2ndStar/denna/denna/CaseDenna/8a386e63-ffc7-4042-83e9-6f8d7a95df95.PNG

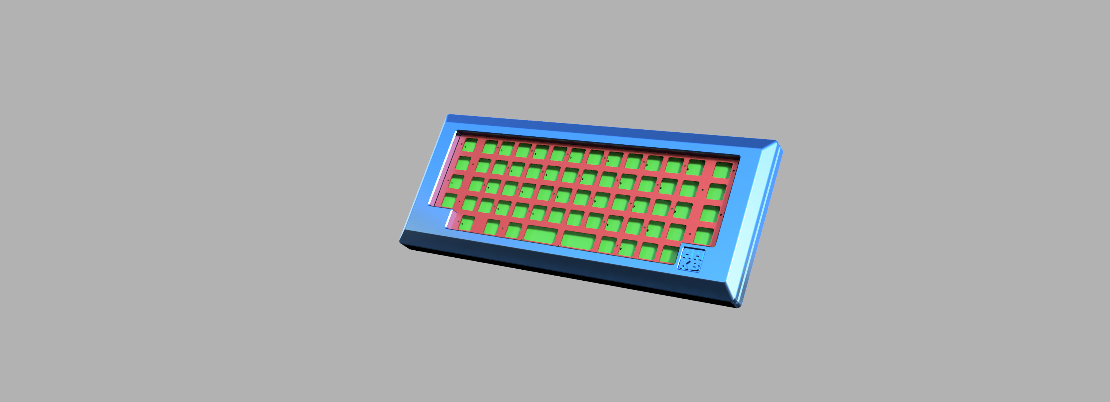
denna/CaseDenna/8a386e63-ffc7-4042-83e9-6f8d7a95df95.PNG
