2ndStar/denna/denna/Production/BOM-denna.csv

Comment | Designator | Footprint | LCSC
1k | R21 | R_0402_1005Metric | C11702
STM32F401CBUx | U2 | QFN-48-1EP_7x7mm_P0.5mm_EP5.6x5.6mm | C118825
OPA350 | U5 | SOIC-8_3.9x4.9mm_P1.27mm | C13388
JST | J1 | JST-SR-4 | C145956
220p | C12 | C_0402_1005Metric | C1530
4.7u | C5 | C_0402_1005Metric | C23733
100 | R23, R24, R25, R26, R27 | R_0402_1005Metric | C25076
100k | R6, R7, R8, R9, R10, R11, R12, R13, R14, R15, R16, R17, R18, R19, R20, R22 | R_0402_1005Metric | C25741
10k | R1, R2, R3 | R_0402_1005Metric | C25744
5.1k | R4, R5 | R_0402_1005Metric | C25905
PRTR5V0U2X | D1 | SOT-143 | C2827688
TYPEC-304YSSW-ACP16 | USB1 | TYPE-C-31-M-12 | C165948
100n | C3, C4, C6, C7, C8, C10, C11, C13 | C_0402_1005Metric | C307331
1u | C1, C2, C9 | C_0402_1005Metric | C52923
XC6206PxxxMR | U1 | SOT-23 | C5446
74HC4051 | U3, U4 | TSSOP16 | C5645
500mA | F1 | Fuse_1206_3216Metric | C70076
8 MHz | Y1 | Resonator_SMD_Murata_CSTxExxV-3Pin_3.0x1.1mm | C907975
