2ndStar/denna/denna/CaseDenna/SQUARE_ROUND_20mm_FEET.stp

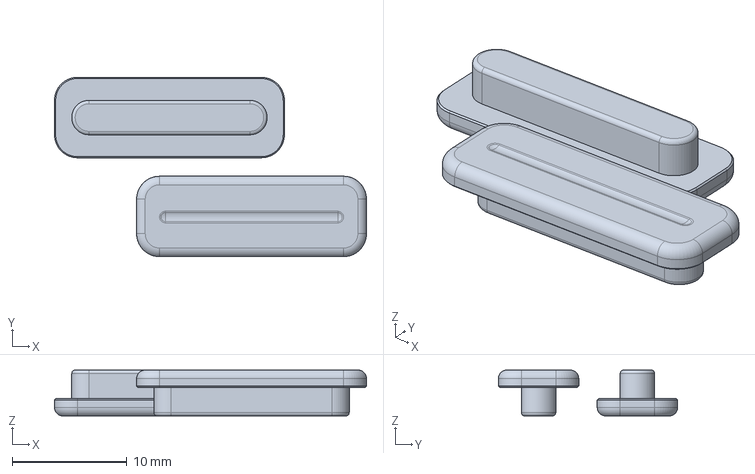
[picture p2: CAD file, 2023-01-30]
denna/CaseDenna/SQUARE_ROUND_20mm_FEET.stp
27.1 x 15.6 x 4.00 mm
