2ndStar/denna/denna/denna-guideplate.dxf

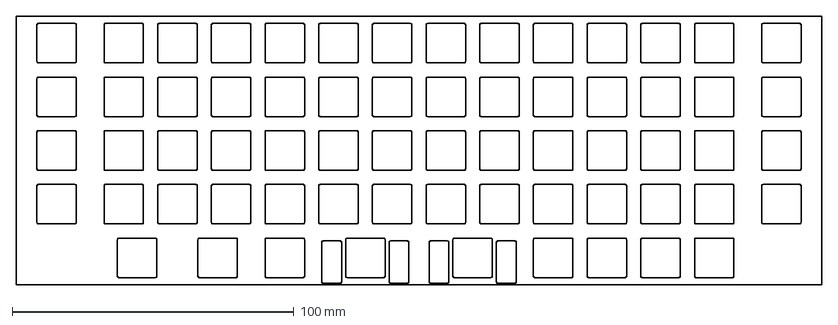
[picture p3: CAD file, 2023-01-30]
denna/denna-guideplate.dxf
285.8 x 95.2 mm
