2ndStar/denna/denna/Production/OG60 ANSI Plate.step

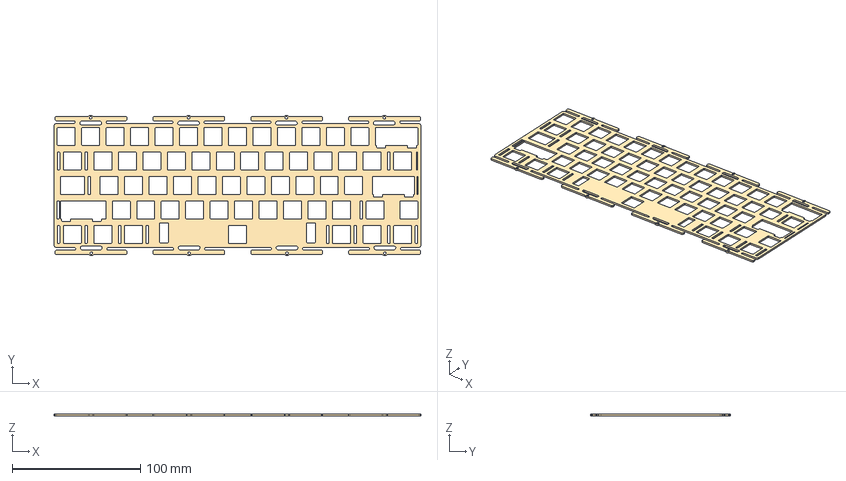
[picture p4: CAD file, 2023-01-30]
denna/Production/OG60 ANSI Plate.step
285.8 x 109.4 x 1.50 mm
