2ndStar/denna/denna/CaseDenna/BottomCase.stl

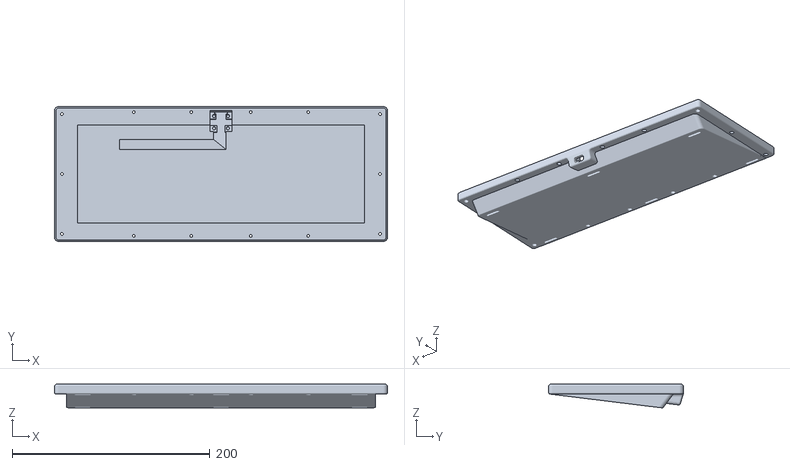
[picture p5: CAD file, 2023-01-30]
denna/CaseDenna/BottomCase.stl
336.7 x 136.2 x 24.1
