2ndStar/denna/denna/CF-Platev1.dxf

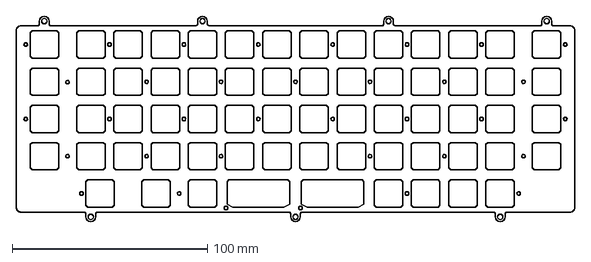
[picture p6: CAD file, 2023-01-30]
denna/CF-Platev1.dxf
285.8 x 105.3 mm
