2ndStar/denna/denna/CaseDenna/SQUARE_ROUND_20mm_FEET1111.step

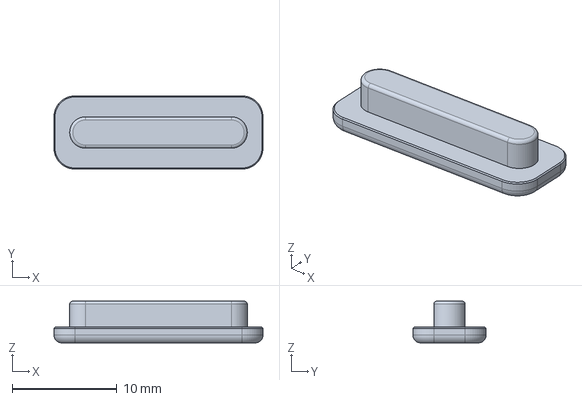
[picture p7: CAD file, 2023-01-30]
denna/CaseDenna/SQUARE_ROUND_20mm_FEET1111.step
20.0 x 7.00 x 4.00 mm
