2ndStar/denna/denna/CaseDenna/TopCase.stl

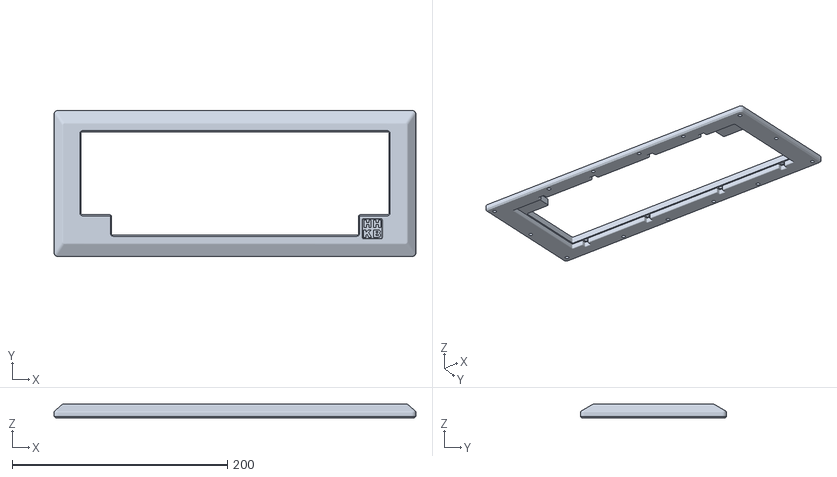
[picture p8: CAD file, 2023-01-30]
denna/CaseDenna/TopCase.stl
336.7 x 136.2 x 13.0
