2ndStar/denna/denna/CaseDenna/DennaPlate.dxf

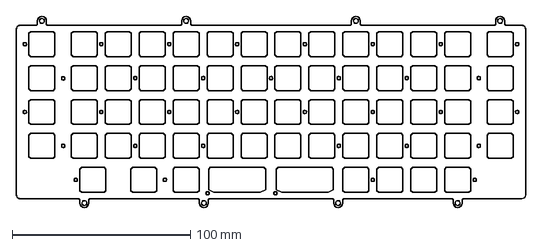
[picture p9: CAD file, 2023-01-30]
denna/CaseDenna/DennaPlate.dxf
285.8 x 107.3 mm
