2ndStar/denna/denna/CaseDenna/denna.step

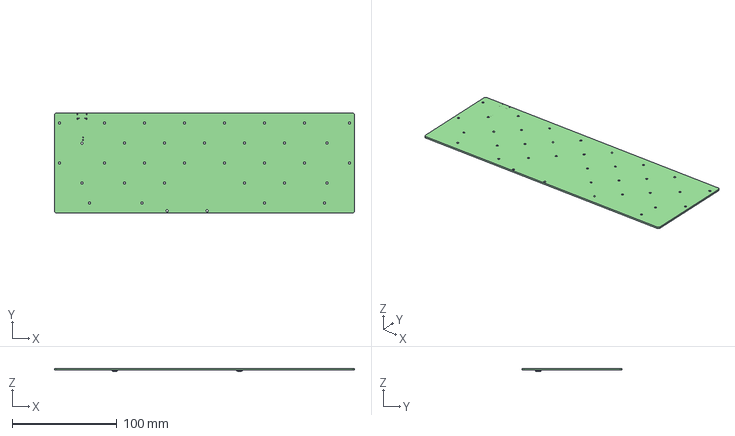
[picture p10: CAD file, 2023-01-30]
denna/CaseDenna/denna.step
285.8 x 95.3 x 3.04 mm
denna PCB
