2ndStar/denna/denna/denna.kicad_pcb

## KiCad design denna/denna.kicad_pcb (2023-01-30)

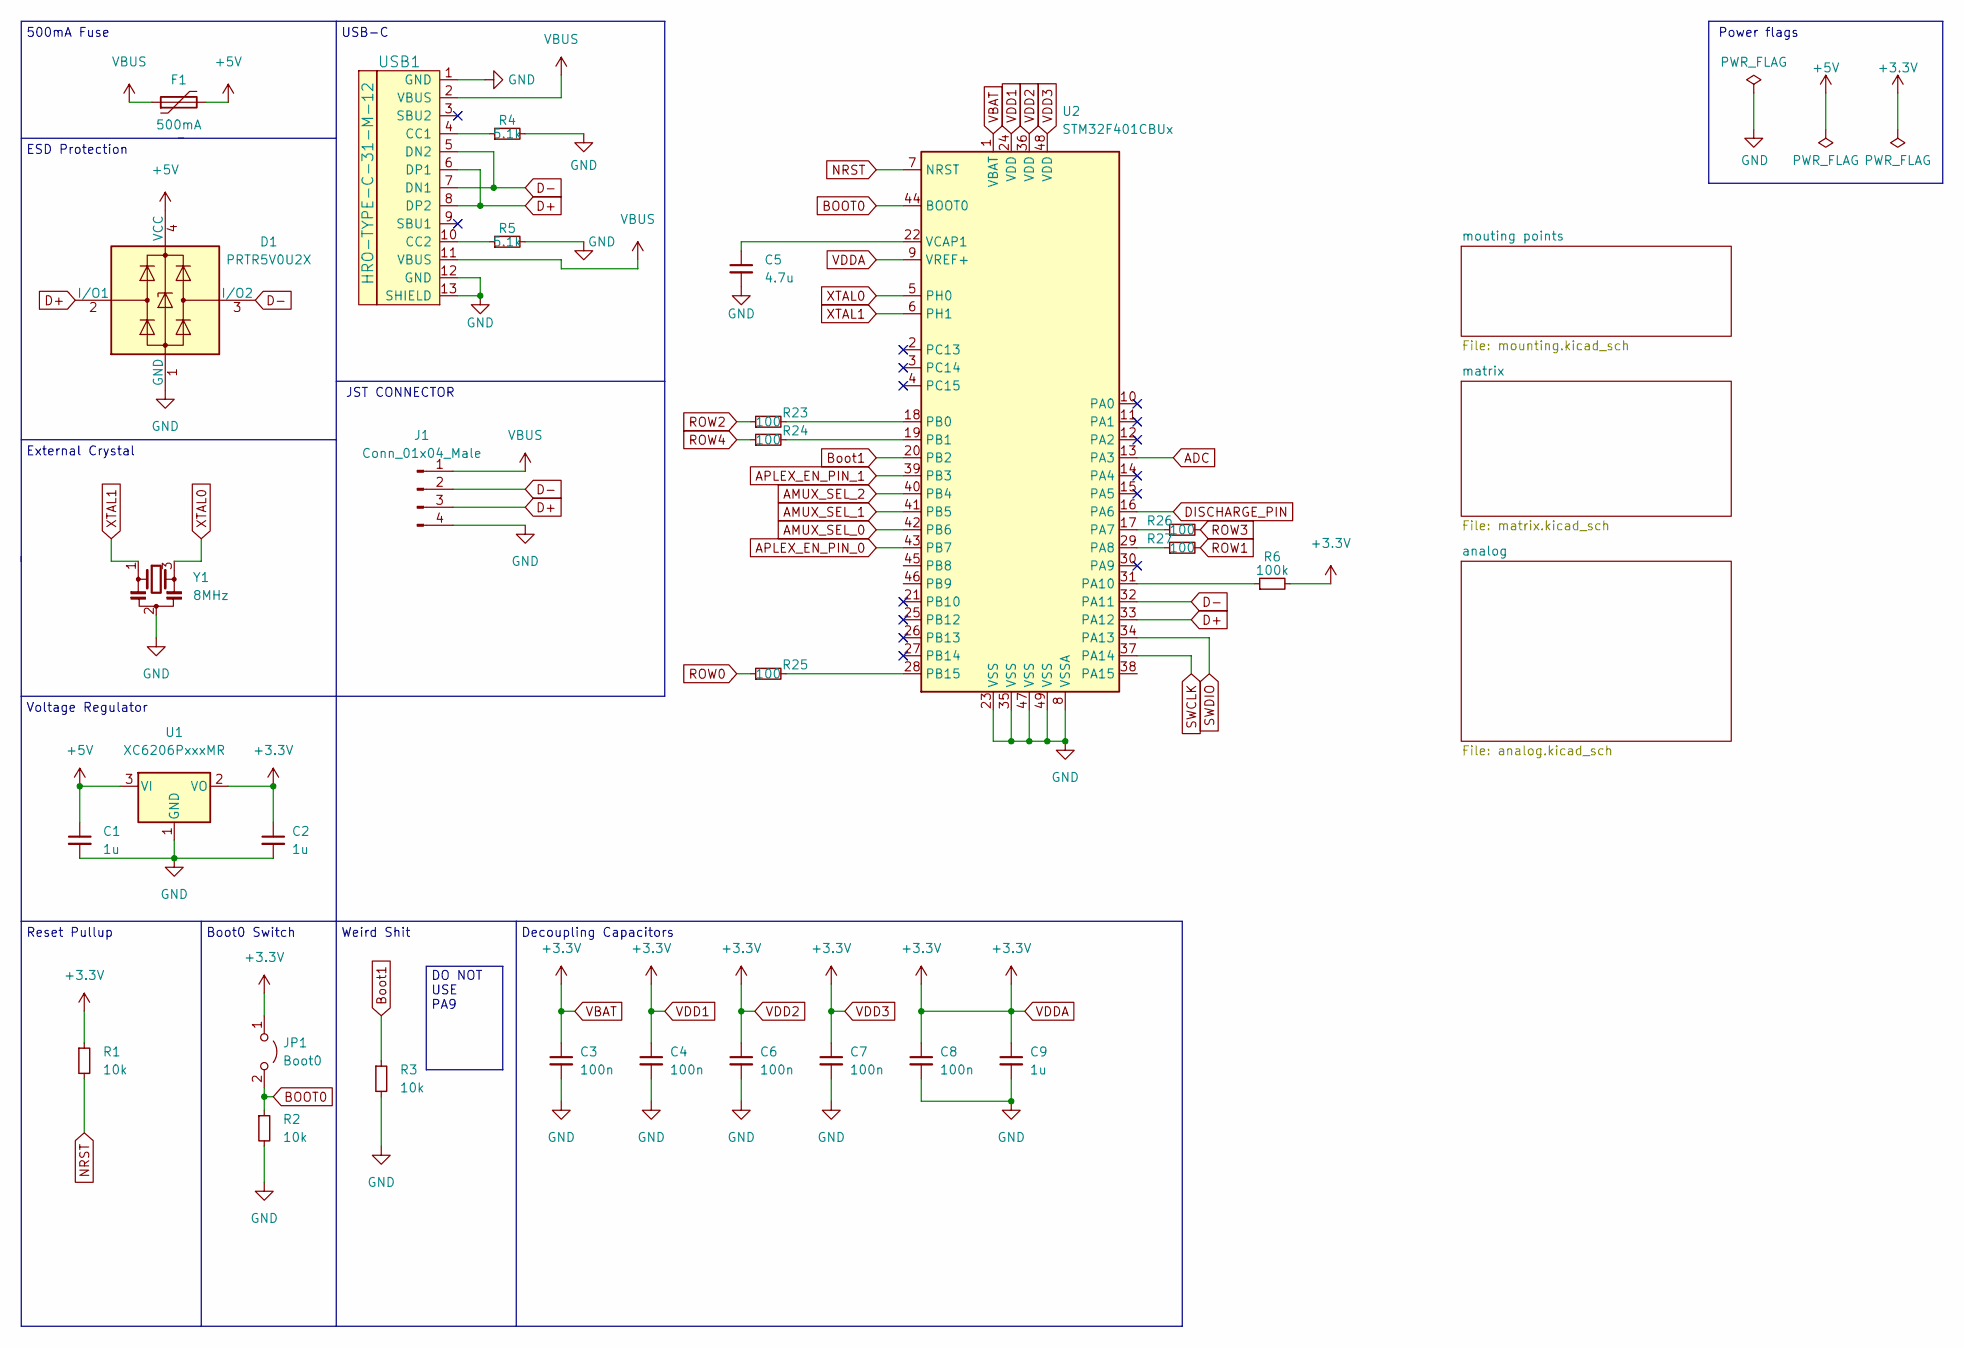
[picture p11: schematic denna.kicad_sch]

Parts:
C1, C2, C9: 1u; C_0402_1005Metric
C3, C4, C6, C7, C8: 100n; C_0402_1005Metric
C5: 4.7u; C_0402_1005Metric
D1: PRTR5V0U2X; SOT-143
F1: 500mA; Fuse_1206_3216Metric
J1: Conn_01x04_Male; JST-SR-4
JP1: Boot0; PinHeader_1x02_P2.54mm_Vertical
R1, R2, R3: 10k; R_0402_1005Metric
R4, R5: 5.1k; R_0402_1005Metric
R6: 100k; R_0402_1005Metric
R23, R24, R25, R26, R27: 100; R_0402_1005Metric
U1: XC6206PxxxMR; SOT-23
U2: STM32F401CBUx; QFN-48-1EP_7x7mm_P0.5mm_EP5.6x5.6mm
USB1: HRO-TYPE-C-31-M-12; HRO-TYPE-C-31-M-12-Assembly
Y1: 8MHz; Resonator_SMD_Murata_CSTxExxV-3Pin_3.0x1.1mm

Connections:
+5V: C1.1, D1.4 (VCC), F1.2, U1.3 (VI)
ADC: U2.13 (PA3); also elsewhere on the board
AMUX_SEL_0: U2.42 (PB6); also elsewhere on the board
AMUX_SEL_1: U2.41 (PB5); also elsewhere on the board
AMUX_SEL_2: U2.40 (PB4); also elsewhere on the board
APLEX_EN_PIN_0: U2.43 (PB7); also elsewhere on the board
APLEX_EN_PIN_1: U2.39 (PB3); also elsewhere on the board
APLEX_OUT_PIN_0: U2.16 (PA6); also elsewhere on the board
BOOT0: JP1.2 (B), R2.1, U2.44 (BOOT0)
Boot1: R3.1, U2.20 (PB2)
D+: D1.2 (I/O1), J1.3, U2.33 (PA12), USB1.6 (DP1), USB1.8 (DP2)
D-: D1.3 (I/O2), J1.2, U2.32 (PA11), USB1.5 (DN2), USB1.7 (DN1)
GND: C1.2, C2.2, C3.2, C4.2, C5.2, C6.2, C7.2, C8.2, C9.2, D1.1 (GND), J1.4, R2.2, R3.2, R4.2, R5.2, U1.1 (GND), U2.8 (VSSA), U2.23 (VSS), U2.35 (VSS), U2.47 (VSS), U2.49 (VSS), USB1.1 (GND), USB1.12 (GND), USB1.13 (SHIELD), Y1.2; also elsewhere on the board
NRST: R1.2, U2.7 (NRST)
unnamed: C5.1, U2.22 (VCAP1)
unnamed: R4.1, USB1.4 (CC1)
unnamed: R5.1, USB1.10 (CC2)
unnamed: R6.1, U2.31 (PA10)
unnamed: R23.2, U2.18 (PB0)
unnamed: R24.2, U2.19 (PB1)
unnamed: R25.2, U2.28 (PB15)
unnamed: R26.1, U2.17 (PA7)
unnamed: R27.1, U2.29 (PA8)
ROW0: R25.1; also elsewhere on the board
ROW1: R27.2; also elsewhere on the board
ROW2: R23.1; also elsewhere on the board
ROW3: R26.2; also elsewhere on the board
ROW4: R24.1; also elsewhere on the board
SWCLK: U2.37 (PA14)
SWDIO: U2.34 (PA13)
VBAT: C2.1, C3.1, C4.1, C6.1, C7.1, C8.1, C9.1, JP1.1 (A), R1.1, R6.2, U1.2 (VO), U2.1 (VBAT), U2.9 (VREF+), U2.24 (VDD), U2.36 (VDD), U2.48 (VDD); also elsewhere on the board
VBUS: F1.1, J1.1, USB1.2 (VBUS), USB1.11 (VBUS)
XTAL0: U2.5 (PH0), Y1.3
XTAL1: U2.6 (PH1), Y1.1

Notes on the sheet:
JST CONNECTOR
Weird Shit
USB-C
ESD Protection
Decoupling Capacitors
Reset Pullup
Power flags
Voltage Regulator
DO NOT USE PA9
External Crystal
Boot0 Switch
500mA Fuse

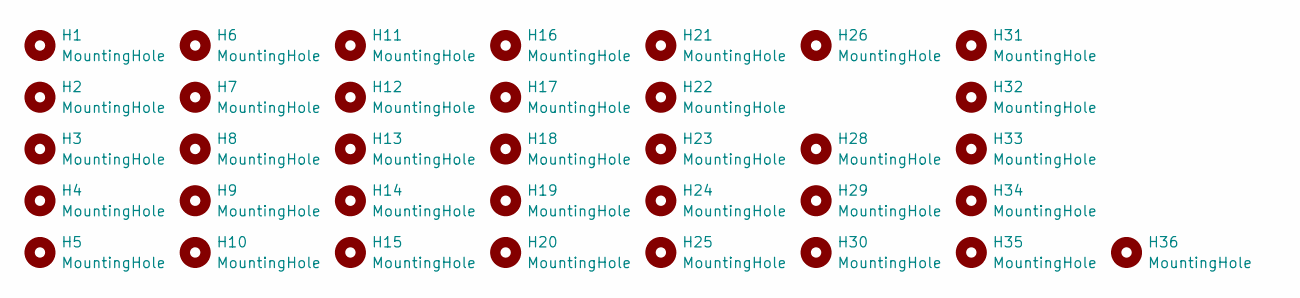
[picture p12: schematic mounting.kicad_sch]

Parts:
H1, H2, H3, H4, H5, H6, H7, H8, H9, H10, H11, H12, H13, H14, H15, H16, H17, H18, H19, H20, H21, H22, H23, H24, H25, H26, H28, H29, H30, H31, H32, H33, H34, H35, H36: MountingHole; HOLE_M2

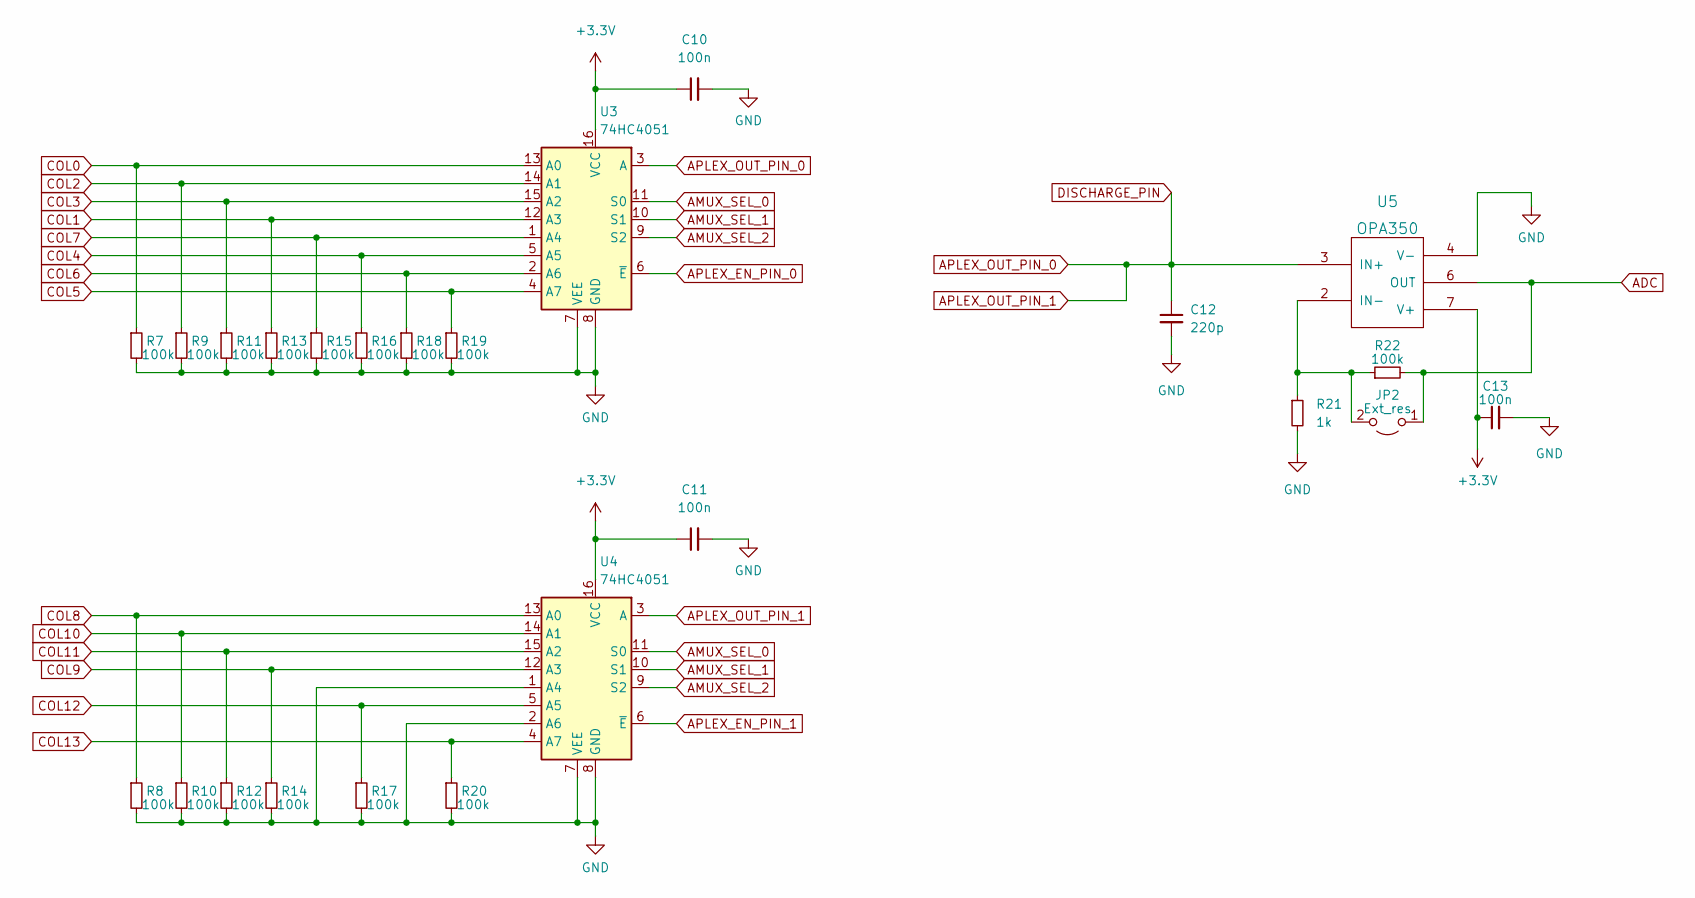
[picture p13: schematic analog.kicad_sch]

Parts:
C10, C11, C13: 100n; C_0402_1005Metric
C12: 220p; C_0402_1005Metric
JP2: Ext_res; R_0603_1608Metric_Pad0.98x0.95mm_HandSolder
R7, R8, R9, R10, R11, R12, R13, R14, R15, R16, R17, R18, R19, R20, R22: 100k; R_0402_1005Metric
R21: 1k; R_0402_1005Metric
U3, U4: 74HC4051; TSSOP16
U5: OPA350; SOIC-8_3.9x4.9mm_P1.27mm

Connections:
ADC: JP2.1 (A), R22.2, U5.6 (OUT); also elsewhere on the board
AMUX_SEL_0: U3.11 (S0), U4.11 (S0); also elsewhere on the board
AMUX_SEL_1: U3.10 (S1), U4.10 (S1); also elsewhere on the board
AMUX_SEL_2: U3.9 (S2), U4.9 (S2); also elsewhere on the board
APLEX_EN_PIN_0: U3.6 (~E); also elsewhere on the board
APLEX_EN_PIN_1: U4.6 (~E); also elsewhere on the board
APLEX_OUT_PIN_0: C12.1, U3.3 (A), U4.3 (A), U5.3 (IN+); also elsewhere on the board
COL0: R7.1, U3.13 (A0); also elsewhere on the board
COL1: R13.1, U3.12 (A3); also elsewhere on the board
COL2: R9.1, U3.14 (A1); also elsewhere on the board
COL3: R11.1, U3.15 (A2); also elsewhere on the board
COL4: R16.1, U3.5 (A5); also elsewhere on the board
COL5: R19.1, U3.4 (A7); also elsewhere on the board
COL6: R18.1, U3.2 (A6); also elsewhere on the board
COL7: R15.1, U3.1 (A4); also elsewhere on the board
COL8: R8.1, U4.13 (A0); also elsewhere on the board
COL9: R14.1, U4.12 (A3); also elsewhere on the board
COL10: R10.1, U4.14 (A1); also elsewhere on the board
COL11: R12.1, U4.15 (A2); also elsewhere on the board
COL12: R17.1, U4.5 (A5); also elsewhere on the board
COL13: R20.1, U4.4 (A7); also elsewhere on the board
GND: C10.2, C11.2, C12.2, C13.2, R7.2, R8.2, R9.2, R10.2, R11.2, R12.2, R13.2, R14.2, R15.2, R16.2, R17.2, R18.2, R19.2, R20.2, R21.2, U3.7 (VEE), U3.8 (GND), U4.1 (A4), U4.2 (A6), U4.7 (VEE), U4.8 (GND), U5.4 (V-); also elsewhere on the board
unnamed: JP2.2 (B), R21.1, R22.1, U5.2 (IN-)
VBAT: C10.1, C11.1, C13.1, U3.16 (VCC), U4.16 (VCC), U5.7 (V+); also elsewhere on the board

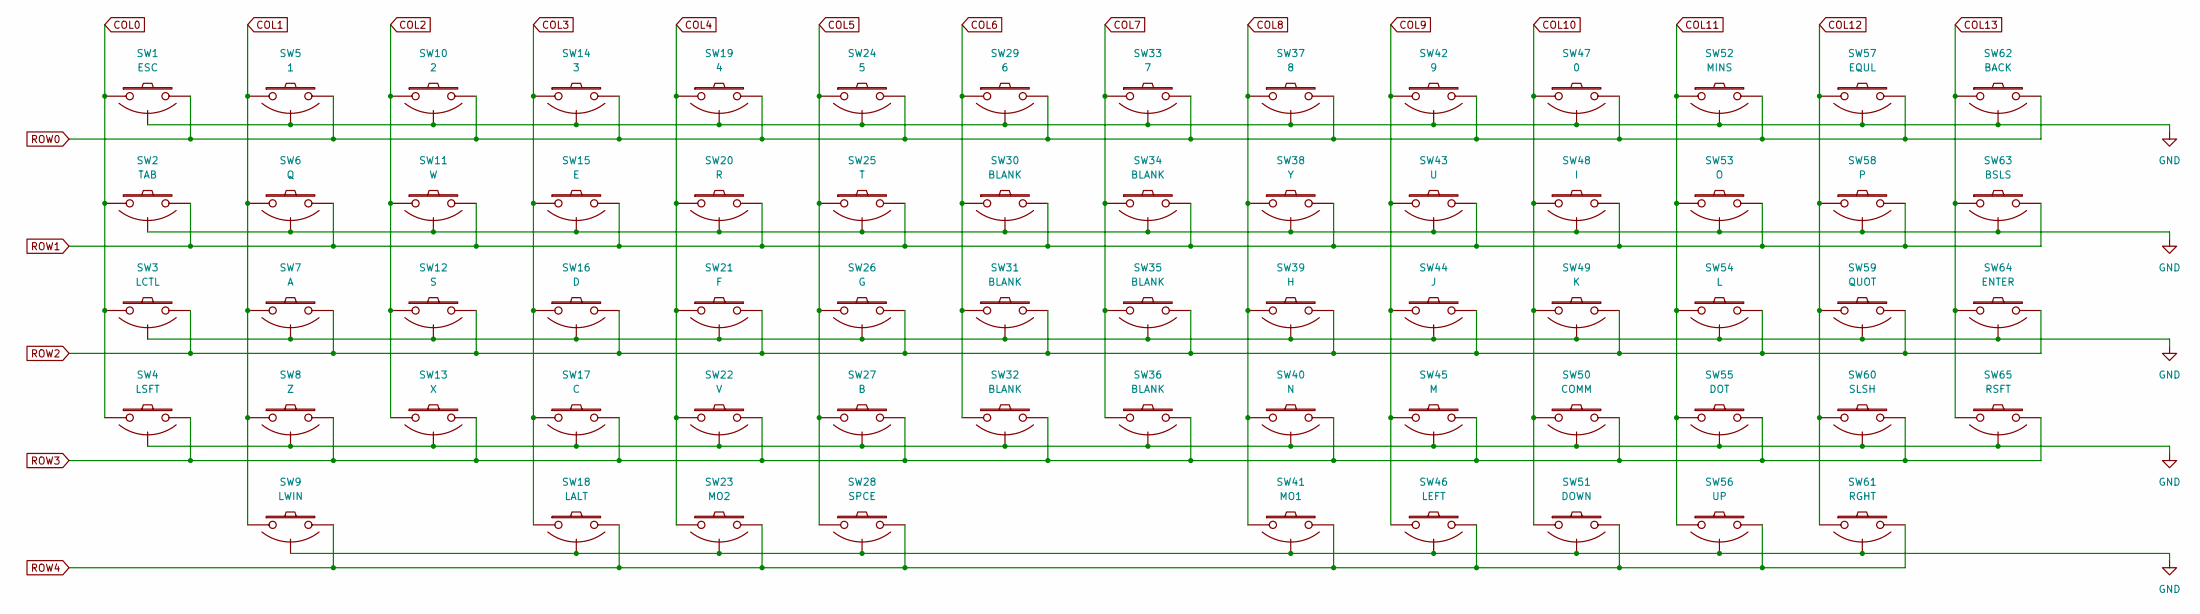
[picture p14: schematic matrix.kicad_sch]

Parts:
SW1: ESC; ecs_pad_no_ring
SW2: TAB; ecs_pad_no_ring
SW3: LCTL; ecs_pad_no_ring
SW4: LSFT; ecs_pad_no_ring
SW5: 1; ecs_pad_no_ring
SW6: Q; ecs_pad_no_ring
SW7: A; ecs_pad_no_ring
SW8: Z; ecs_pad_no_ring
SW9: LWIN; ecs_pad_no_ring
SW10: 2; ecs_pad_no_ring
SW11: W; ecs_pad_no_ring
SW12: S; ecs_pad_no_ring
SW13: X; ecs_pad_no_ring
SW14: 3; ecs_pad_no_ring
SW15: E; ecs_pad_no_ring
SW16: D; ecs_pad_no_ring
SW17: C; ecs_pad_no_ring
SW18: LALT; ecs_pad_no_ring
SW19: 4; ecs_pad_no_ring
SW20: R; ecs_pad_no_ring
SW21: F; ecs_pad_no_ring
SW22: V; ecs_pad_no_ring
SW23: MO2; ecs_pad_no_ring
SW24: 5; ecs_pad_no_ring
SW25: T; ecs_pad_no_ring
SW26: G; ecs_pad_no_ring
SW27: B; ecs_pad_no_ring
SW28: SPCE; ecs_pad_no_ring
SW29: 6; ecs_pad_no_ring
SW30, SW31, SW32, SW34, SW35, SW36: BLANK; ecs_pad_no_ring
SW33: 7; ecs_pad_no_ring
SW37: 8; ecs_pad_no_ring
SW38: Y; ecs_pad_no_ring
SW39: H; ecs_pad_no_ring
SW40: N; ecs_pad_no_ring
SW41: MO1; ecs_pad_no_ring
SW42: 9; ecs_pad_no_ring
SW43: U; ecs_pad_no_ring
SW44: J; ecs_pad_no_ring
SW45: M; ecs_pad_no_ring
SW46: LEFT; ecs_pad_no_ring
SW47: 0; ecs_pad_no_ring
SW48: I; ecs_pad_no_ring
SW49: K; ecs_pad_no_ring
SW50: COMM; ecs_pad_no_ring
SW51: DOWN; ecs_pad_no_ring
SW52: MINS; ecs_pad_no_ring
SW53: O; ecs_pad_no_ring
SW54: L; ecs_pad_no_ring
SW55: DOT; ecs_pad_no_ring
SW56: UP; ecs_pad_no_ring
SW57: EQUL; ecs_pad_no_ring
SW58: P; ecs_pad_no_ring
SW59: QUOT; ecs_pad_no_ring
SW60: SLSH; ecs_pad_no_ring
SW61: RGHT; ecs_pad_no_ring
SW62: BACK; ecs_pad_no_ring
SW63: BSLS; ecs_pad_no_ring
SW64: ENTER; ecs_pad_no_ring
SW65: RSFT; ecs_pad_no_ring

Connections:
COL0: SW1.1, SW2.1, SW3.1, SW4.1; also elsewhere on the board
COL1: SW5.1, SW6.1, SW7.1, SW8.1, SW9.1; also elsewhere on the board
COL2: SW10.1, SW11.1, SW12.1, SW13.1; also elsewhere on the board
COL3: SW14.1, SW15.1, SW16.1, SW17.1, SW18.1; also elsewhere on the board
COL4: SW19.1, SW20.1, SW21.1, SW22.1, SW23.1; also elsewhere on the board
COL5: SW24.1, SW25.1, SW26.1, SW27.1, SW28.1; also elsewhere on the board
COL6: SW29.1, SW30.1, SW31.1, SW32.1; also elsewhere on the board
COL7: SW33.1, SW34.1, SW35.1, SW36.1; also elsewhere on the board
COL8: SW37.1, SW38.1, SW39.1, SW40.1, SW41.1; also elsewhere on the board
COL9: SW42.1, SW43.1, SW44.1, SW45.1, SW46.1; also elsewhere on the board
COL10: SW47.1, SW48.1, SW49.1, SW50.1, SW51.1; also elsewhere on the board
COL11: SW52.1, SW53.1, SW54.1, SW55.1, SW56.1; also elsewhere on the board
COL12: SW57.1, SW58.1, SW59.1, SW60.1, SW61.1; also elsewhere on the board
COL13: SW62.1, SW63.1, SW64.1, SW65.1; also elsewhere on the board
GND: SW1.3 (SG), SW2.3 (SG), SW3.3 (SG), SW4.3 (SG), SW5.3 (SG), SW6.3 (SG), SW7.3 (SG), SW8.3 (SG), SW9.3 (SG), SW10.3 (SG), SW11.3 (SG), SW12.3 (SG), SW13.3 (SG), SW14.3 (SG), SW15.3 (SG), SW16.3 (SG), SW17.3 (SG), SW18.3 (SG), SW19.3 (SG), SW20.3 (SG), SW21.3 (SG), SW22.3 (SG), SW23.3 (SG), SW24.3 (SG), SW25.3 (SG), SW26.3 (SG), SW27.3 (SG), SW28.3 (SG), SW29.3 (SG), SW30.3 (SG), SW31.3 (SG), SW32.3 (SG), SW33.3 (SG), SW34.3 (SG), SW35.3 (SG), SW36.3 (SG), SW37.3 (SG), SW38.3 (SG), SW39.3 (SG), SW40.3 (SG), SW41.3 (SG), SW42.3 (SG), SW43.3 (SG), SW44.3 (SG), SW45.3 (SG), SW46.3 (SG), SW47.3 (SG), SW48.3 (SG), SW49.3 (SG), SW50.3 (SG), SW51.3 (SG), SW52.3 (SG), SW53.3 (SG), SW54.3 (SG), SW55.3 (SG), SW56.3 (SG), SW57.3 (SG), SW58.3 (SG), SW59.3 (SG), SW60.3 (SG), SW61.3 (SG), SW62.3 (SG), SW63.3 (SG), SW64.3 (SG), SW65.3 (SG); also elsewhere on the board
ROW0: SW1.2, SW5.2, SW10.2, SW14.2, SW19.2, SW24.2, SW29.2, SW33.2, SW37.2, SW42.2, SW47.2, SW52.2, SW57.2, SW62.2; also elsewhere on the board
ROW1: SW2.2, SW6.2, SW11.2, SW15.2, SW20.2, SW25.2, SW30.2, SW34.2, SW38.2, SW43.2, SW48.2, SW53.2, SW58.2, SW63.2; also elsewhere on the board
ROW2: SW3.2, SW7.2, SW12.2, SW16.2, SW21.2, SW26.2, SW31.2, SW35.2, SW39.2, SW44.2, SW49.2, SW54.2, SW59.2, SW64.2; also elsewhere on the board
ROW3: SW4.2, SW8.2, SW13.2, SW17.2, SW22.2, SW27.2, SW32.2, SW36.2, SW40.2, SW45.2, SW50.2, SW55.2, SW60.2, SW65.2; also elsewhere on the board
ROW4: SW9.2, SW18.2, SW23.2, SW28.2, SW41.2, SW46.2, SW51.2, SW56.2, SW61.2; also elsewhere on the board

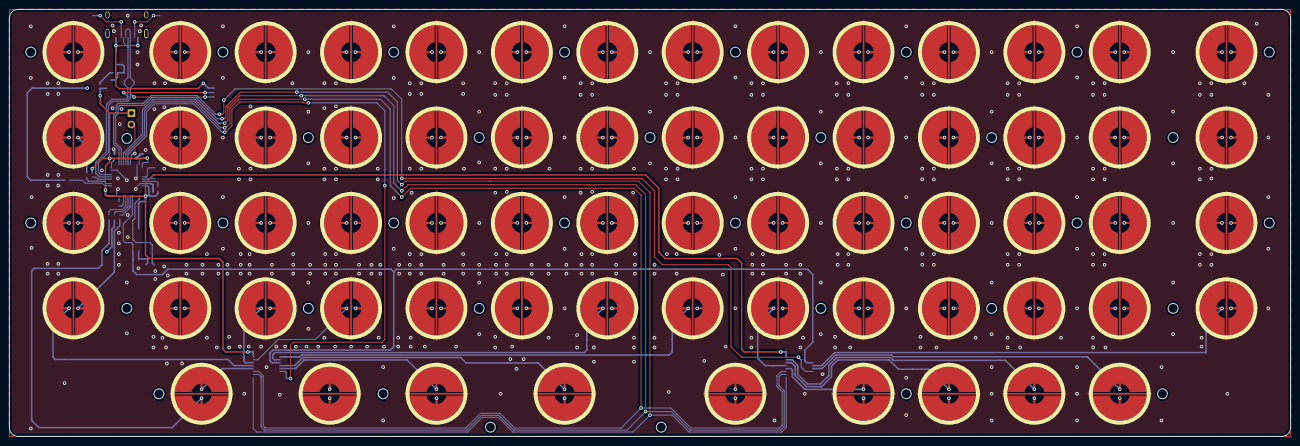
[picture p15: board denna.kicad_pcb from above]

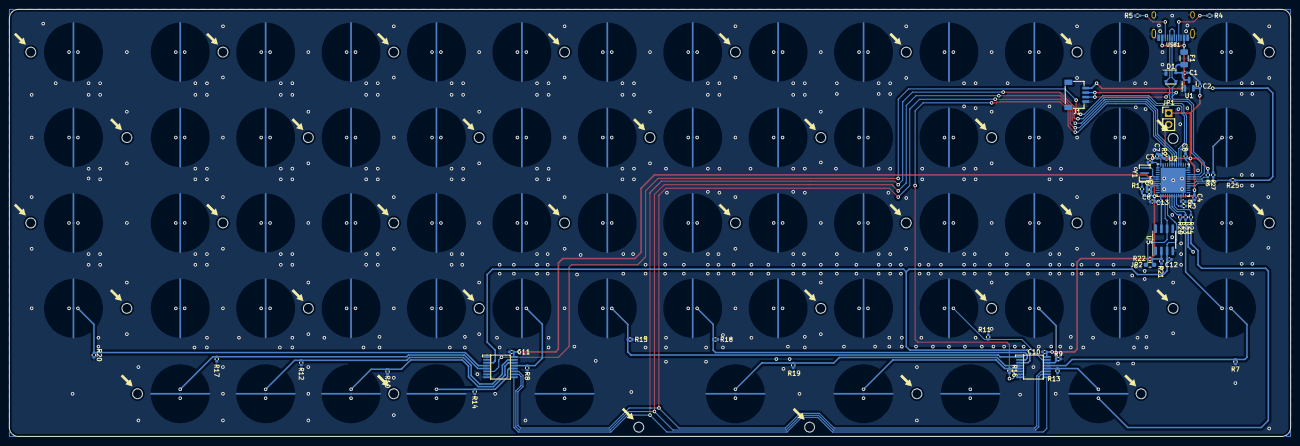
[picture p16: board denna.kicad_pcb from below]

Board: 4 copper layers, 285.8 x 95.3 mm, 152 parts (52 on the bottom side), 47 nets.
