2ndStar/denna/denna/Firmware/denna.h

#pragma once

#include "quantum.h"

#define LAYOUT_all( \
    k000,  k001,  k002,  k003,  k004,  k005,  k006,  k007,  k008,  k009,  k010,  k011,  k012,  k013,\
    k100,  k101,  k102,  k103,  k104,  k105,  k106,  k107,  k108,  k109,  k110,  k111,  k112,  k113,\
    k200,  k201,  k202,  k203,  k204,  k205,  k206,  k207,  k208,  k209,  k210,  k211,  k212,  k213,\
    k300,  k301,  k302,  k303,  k304,  k305,  k306,  k307,  k308,  k309,  k310,  k311,  k312,  k313,\
           k401,         k403,  k404,  k405,                k408,  k409,  k410,  k411,  k412\
) { \
    { k000,   k001,  k002,   k003,  k004,  k005, k006,  k007,  k008, k009, k010, k011,  k012,  k013}, \
    { k100,   k101,  k102,   k103,  k104,  k105, k106,  k107,  k108, k109, k110, k111,  k112,  k113}, \
    { k200,   k201,  k202,   k203,  k204,  k205, k206,  k207,  k208, k209, k210, k211,  k212,  k213}, \
    { k300,   k301,  k302,   k303,  k304,  k305, k306,  k307,  k308, k309, k310, k311,  k312,  k313}, \
    { KC_NO,  k401,  KC_NO,  k403,  k404,  k405, KC_NO, KC_NO, k408, k409, k410, k411,  k412,  KC_NO}  \
}
